aiden-lee11/clickshot/demo/README.md

# Clickshot — split walkthrough demo

Run `npm start` from `~/Developer/clickshot/demo`, then open http://127.0.0.1:4173. Run `npm install` if dependencies are missing. `npm run check` checks JavaScript syntax.

## Presentation

The laptop camera and the physical scene share targets A, B and C. Click a target in either view or select **Play example**. The six-step sequence shows:

1. A camera click selects a stationary target.
2. The laptop converts pixel offsets to yaw and pitch (pinhole-camera angle calculation, with illustrative intrinsics).
3. An animated USB packet hands the command to the microcontroller.
4. The microcontroller moves the yaw and pitch servos. The orange aim marker converges on the selected target.
5. Only after centering, the simulated rangefinder samples the target distance.
6. The microcontroller applies an illustrative pitch trim and waits for confirmation.

Use the step buttons to revisit a stage, Pause/Resume to explain it, and Replay to restart from the home pose. Confirm foam shot or Simulate clap animates a foam dart; each shot needs another confirmation. Manual controls are folded away. Drag the 3D scene to orbit; Isometric restores the presentation view.

All camera, serial, sensor, microphone and firing events are simulated. Range trim is `(range − 1) × 1.2°`, an illustrative animation convention, not a calibrated ballistic solution. The displayed physical distances are illustrative; the 3D stage compresses distance for legibility. The visible dart animation is a presentation effect.

## Buildable mount concept

The model distinguishes matte printed parts, bought metal hardware, and a plywood base:

- **Print:** two gusseted cheek plates, an open frame cradle with balance adjustment slots, servo pockets/adapters, and bearing retainers. Candidate material: PETG. Velcro-style straps and pads secure the shell without blocking the top jam door or magazine removal.
- **Buy:** two 608 bearings; M8 bolts with smooth sleeves/spacers, washers and locknuts for the two short side pivots; M3 fasteners; a lazy-Susan turntable bearing; two standard positional metal-gear hobby servos with matching horns; plywood and soft feet.
- The two short pivot bolts attach to opposite sides of the printed cradle. No shaft passes through the blaster. Bearings support the pitch pivots, and a horn screws into a printed adapter to transfer servo torque.
- The bought turntable is bolted between the base and printed yaw deck. Its bearing supports the vertical load. A coaxial servo/horn adapter turns the deck. Hardware fit, assembly access and cable slack must be resolved in CAD around the actual purchased parts.
- Align the loaded center of mass with the pitch pivots using the slotted cradle. The model is not dimensioned CAD or a structural validation. Measure blaster mass, loaded balance, clearances and required torque before buying servos. Bearing fit and printed-part strength need prototype checks. No custom metal machining is assumed; ordinary drilling and screw assembly are.

### Manufacturer and assembly references

- [Adafruit: 608 bearings installed in printed servo holders](https://learn.adafruit.com/animatronic-cosplay-wings/servos-assembly)
- [Pololu: standard-size servo bracket and M3 mounting](https://www.pololu.com/product/3435)
- [LILY Bearing: lazy-Susan bearing examples](https://www.lily-bearing.com/product/applications/lazy-susan-bearings/)
- [Adafruit: standard metal-gear servo example](https://www.adafruit.com/product/1142)

These are component examples, not a validated purchase list or a claim that a particular servo will carry this blaster. The linked shopping lists distinguish listed prices from planning allowances; the mock does not validate load ratings.

## Source

`index.html` contains the split presentation interface; `style.css` the responsive layout; `app.js` the procedural Three.js model, target coordinates and walkthrough state machine; `server.mjs` serves on loopback locally, and on `0.0.0.0` in production using Railway’s `PORT`. Only presentation assets, build notes and Three.js modules are public. Three.js is pinned in the package lock and served locally. The app makes no remote runtime requests. Reference links only open when clicked.

## Rapidstrike and second-stage presentation revision

The procedural blaster now follows the full Rapidstrike CS-18 silhouette and a published approximate 685 mm length reference. The new `mount-plan.md` records the source, proposed 360 × 300 mm base, 140 mm inner gap and 250 mm pivot height, and a linked candidate BOM. Local shell geometry and fit remain provisional until measured. Open **Original mount → View mount shopping list** for the supplier table and a plan download.

The embedded stage has larger live readings and a dedicated before/trim/after pitch comparison. The correction ramps over 3.2 seconds, with a blue camera-centered ghost pose and reference ray. The actual gun angle and orange ray move by the displayed trim; the physical rotation is not artificially magnified. **Replay trim** restarts just that motion. The laptop's command values are smaller and fade after handoff. Styling for this revision is isolated in `stage-two.css`.

## Plywood mount alternative

The **Plywood alternative** tab adds a separate assembly while preserving the original printed mount. It uses a plywood deck/uprights/open cradle, ordinary angle brackets, a bought yaw bearing, supported pitch pivots and small printed adapters. Yaw/pitch sliders, an automatic sweep and the shared exploded-view control demonstrate both axes. The pitch crank/pushrod stays connected in the assembled animation. See `plywood-mount-plan.md` for provisional dimensions, parts, Ford-resource assumptions and assembly notes. This is a concept mock, not validated CAD or a load-tested mechanism.

## Shared budget assumptions

The team has a micro:bit, cables, resistors, access to a 3D printer and existing filament spools. Printing is $0 new spend for both mount options. Both lists keep straps budgeted and show the same two cases: purchase other mount materials, or conditionally obtain wood/common hardware from Ford at no charge. Ford stock remains unconfirmed. Original mount: $98.36 / $71.42; plywood alternative: $115.93 / $81.42. Both include two aiming servos and exclude the rest of the electrical system, tax and shipping.

## Railway hosting

Live demo: https://clickshot-demo-production.up.railway.app

The initial deployment uses the Railway CLI. GitHub automatic deployment is **not connected yet** because the existing Railway GitHub integration could not access this repository.

Deploy the GitHub repository `aiden-lee11/clickshot`, branch `main`, with service **Root Directory** `/demo` and **Railway Config File** `/demo/railway.json`. Railpack installs the locked dependencies and runs `npm start`. Set `NODE_ENV=production`; Railway supplies `PORT`. Health checks request `/`. No database or application secrets are needed.

When the service is connected to GitHub with automatic deployments enabled, pushing changes to `main` updates the shared demo. Run `npm run check` before pushing. For a manual deployment from the linked repository root, run `railway up demo --path-as-root --service clickshot-demo`. This uploads only the demo folder as the deployment root; keep Root Directory unset for this CLI workflow. Run `railway link` first on another computer and select the Clickshot project.

To enable automatic deployments later, grant the Railway GitHub app access to this repository, connect the service to `aiden-lee11/clickshot` on `main`, and set the GitHub service Root Directory to `/demo` with config path `/demo/railway.json`. Do not use the folder-as-root CLI upload after setting that GitHub root directory.

Reference: [Railway monorepo settings](https://docs.railway.com/deployments/monorepo) and [GitHub automatic deployments](https://docs.railway.com/deployments/github-autodeploys).

## Prototype CAD

Open `/cad/` for the CAD-mesh viewer, exported STEP assembly, print-oriented STLs and source ZIP. The generator and editable dimensions live in `cad/generate.py` and `cad/parameters.json`. Read `cad/README.md` before fabrication. The CAD is a fit draft of the printed mount, with an external pitch linkage and optional replacement sleeves, while both presentation concepts remain preserved. Its provisional hardware schedule differs from the original concept shopping list; existing shopping totals are not quotes for the CAD revision.

## Compact inverted concept

The **Compact inverted** tab adds a third material-first mount mock. The receiver is shortened and inverted, with the magazine above, two short cutout cheeks, light saddles/rails, a web deck and side-driven yaw. The existing printed/plywood scenes and earlier CAD pack are preserved. `compact-mount.js` owns the new procedural assembly and crank/rod closures; `compact.css` its presentation. See `compact-mount-plan.md` for the proposed 100 mm pitch height, 260 × 220 mm base, material-proxy methodology and unresolved balance/inverted-feeding checks. The on-screen plastic-volume reduction compares rendered print-material geometry against the original scene, not slicer filament or CAD strength. This concept has no new fabrication CAD.

## Recommended hybrid and build navigation

The top navigation now has **Walkthrough** and **Mount builds**. A selector and previous/next arrows switch among the four assemblies: Original printed, Plywood frame, Compact inverted and Recommended hybrid. Direct links use `#original`, `#plywood`, `#compact` and `#recommended`.

The recommended mock shares the illustrative trimmed receiver with the compact model, but uses solid flat plywood uprights/deck, small printed bearing housings, bought pitch bearings, wood risers and coaxial yaw underneath. It has one pitch linkage. See `recommended-mount-plan.md`; this concept does not replace or update the earlier CAD pack or price lists.

## Recommended-build shopping list

Open **Mount builds → Recommended hybrid → View complete shopping list**. The dialog covers mount/movement, sensing/interfaces, power/blaster switching, and demo consumables. `recommended-shopping.js` is the single source for quantities, integer-cent prices, estimates and conditional Ford savings. `node scripts/build-shopping-list.mjs` regenerates the downloadable `recommended-shopping-list.md`; run it after changing the data. The app serves both locally without external runtime requests.

This is a complete candidate BOM, unlike the earlier mount-only lists. It assumes reuse of the donor Rapidstrike/magazine/tray and webcam named in the project notes; conditional replacement allowances are excluded. Micro:bit, class signal/USB cables, resistors, printer and filament are covered. Motor power wire and specialized connections are budgeted separately. Supply/driver ratings, pivot hardware, linkage and servo torque require physical selection checks; the recommended mock is not fabrication CAD.

## Class-resource budget revision

The recommended shopping dialog now leads with a conditional **$62.75 parts plan**, leaving **$57.25** toward tax/shipping/missing supplies within $120. Without class breakout/two pots and usable existing C cells, the parts subtotal is **$80.17** before tax/shipping. Both cases depend on confirmed Ford wood/hardware/clamps, adequate borrowed servo power and class wiring/capacitors/board, plus reuse of small consumables. They are not confirmed-free-stock or guaranteed checkout totals. The retail fallback now totals $232.34 with the two aiming servos marked owned, replacing the earlier $272.24 reference that included buying them.

`recommended-budget.js` derives the source groups and new purchase subtotals from the original retail data, substituting a $3.99 two-pack of 8×22×7 mm bearings for the $15.54 pair. Regenerate both Markdown files with `node scripts/build-shopping-list.mjs`. See `recommended-budget-plan.md` for sources, exact reconciliation, missing-resource add-backs and retained MVP functions.

Both aiming servos are confirmed owned. Their exact models are unspecified, so their power requirements, mounting pattern and horn spline must be measured before choosing adapters or treating the example 5 V supply as suitable. Ownership reduces the new-purchase budget by the prior $39.90 allowance; it does not identify the servos as the linked Adafruit model.

## Wiring visualization

Enable **Show wiring** under the build selector in **Mount builds**. The same toggle applies to all four assemblies and stays selected while switching builds. It starts off; the walkthrough remains unchanged. Wiring mode replaces dimension callouts with a compact color key and labels the base controller, motor switches, servo power and two separate laptop USB connections.

`build-wiring.js` anchors cable bundles to the fixed base, yaw frame, pitch cradle and blaster in each model. They follow yaw/pitch sweeps and the exploded view, with illustrative service loops at both joints. Servo power/common ground, servo/motor control, range/position feedback, camera/controller USB and both switched blaster motor branches are distinct. The camera USB route returns directly to the laptop rather than through the micro:bit. Light markers illustrate signal direction, not live serial traffic. The overlays and extra base components hide when disabled or in Walkthrough.

The wiring is a routing concept, not an electrical schematic, physical clearance validation, exact wire count/length, selected gauge or final pin mapping. The exploded view stretches routes for presentation. Added base component envelopes and feedback endpoints are provisional. Verify actual owned-servo power requirements and complete the circuit design before assembly. Cable geometry buffers are reused and reshaped only while the pose changes; hidden builds do not update their wiring.

## Manual aiming and simulated shots

In **Walkthrough → Manual controls**, changing yaw or pitch enters manual aiming mode. The turret moves smoothly to those angles; **Confirm foam shot**, **Simulate clap** and the existing space shortcut become available once the aim settles. No laptop target click is required. A manual shot follows the current barrel direction to the selected demo range rather than snapping to a previous target. Manual pitch is used directly; the automatic range-trim walkthrough is bypassed in this mode. Each action fires one simulated dart and shares a 1.2-second cooldown.

Clicking a laptop/scene target returns to the automatic walkthrough. Reset and tab/build changes clear manual readiness. Mount builds remain assembly views. The fire handler and buttons share the same eligibility check, including alignment and cooldown, so keyboard input cannot bypass movement or firing cooldown.
