aiden-lee11/clickshot/demo/cad/generated/clickshot-assembly.step

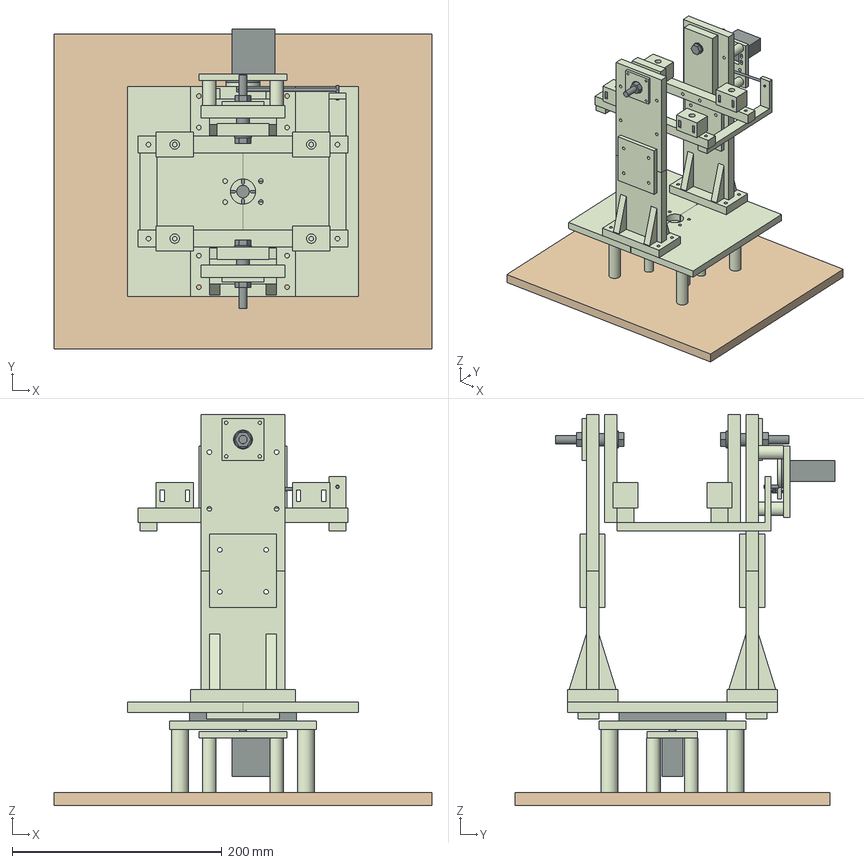
[picture p1: CAD file, 2026-10-26]
demo/cad/generated/clickshot-assembly.step
360.0 x 304.9 x 372.6 mm
yaw_deck_left
yaw_deck_right
deck_joiner_0
deck_joiner_1
bearing_platform
yaw_post_0
yaw_post_1
yaw_post_2
yaw_post_3
yaw_horn_adapter
servo_carrier_yaw
yaw_servo_post_0
yaw_servo_post_1
yaw_servo_post_2
yaw_servo_post_3
pitch_servo_carrier_pitch
pitch_servo_post_0
pitch_servo_post_1
pitch_servo_post_2
pitch_servo_post_3
lower_cheek_-1
upper_cheek_-1
cheek_splice_-1_-1
cheek_splice_-1_1
bearing_retainer_-1
cradle_rail_-1
cradle_pivot_ear_-1
saddle_block_-1_0
saddle_block_-1_1
608_bearing_-1
pivot_spacer_-1
M8_pivot_reference_-1
M8_washer_inner_-1
M8_washer_outer_-1
M8_head_-1
M8_nut_-1
lower_cheek_1
upper_cheek_1
cheek_splice_1_-1
cheek_splice_1_1
bearing_retainer_1
cradle_rail_1
cradle_pivot_ear_1
saddle_block_1_0
saddle_block_1_1
608_bearing_1
pivot_spacer_1
M8_pivot_reference_1
M8_washer_inner_1
M8_washer_outer_1
M8_head_1
M8_nut_1
rear_crossmember
front_drive_crossmember
pitch_crank_adapter
pushrod_reference
servo_joint_pin
cradle_joint_pin
yaw_servo_envelope
yaw_bought_horn_reference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
