aiden-lee11/clickshot/demo/cad/generated/preview/servo_joint_pin.stl

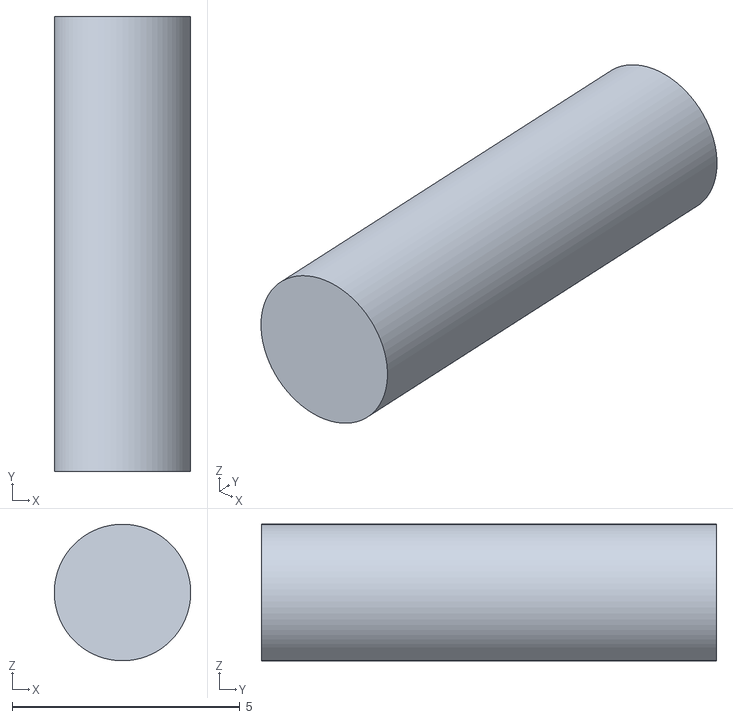
[picture p2: CAD file, 2026-10-26]
demo/cad/generated/preview/servo_joint_pin.stl
3.00 x 10.0 x 3.00
