aiden-lee11/clickshot/demo/cad/generated/step/yaw_post.step

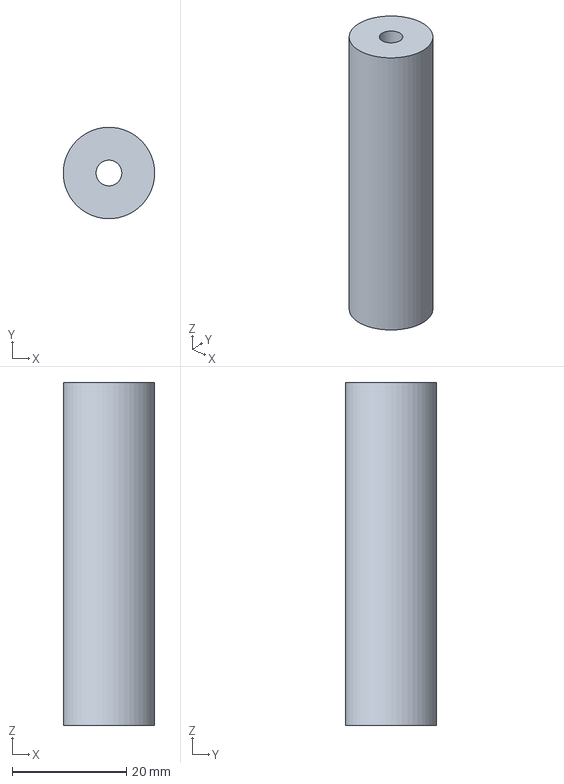
[picture p3: CAD file, 2026-10-26]
demo/cad/generated/step/yaw_post.step
16.0 x 16.0 x 60.0 mm
