aiden-lee11/clickshot/demo/cad/generated/preview/pitch_servo_post_2.stl

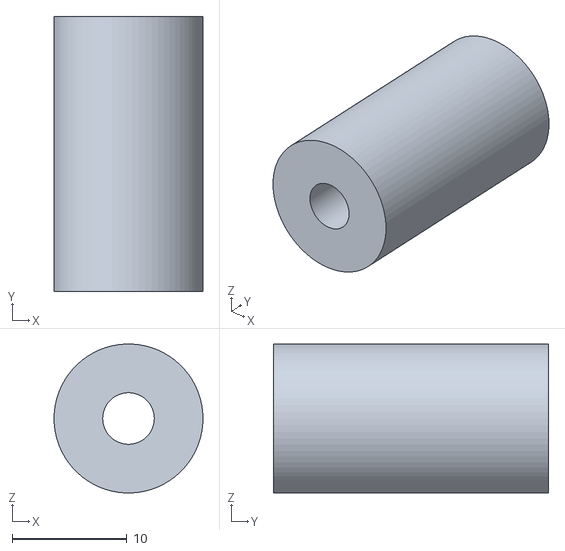
[picture p4: CAD file, 2026-10-26]
demo/cad/generated/preview/pitch_servo_post_2.stl
13.0 x 24.0 x 13.0
