aiden-lee11/clickshot/demo/cad/generated/preview/lower_cheek_-1.stl

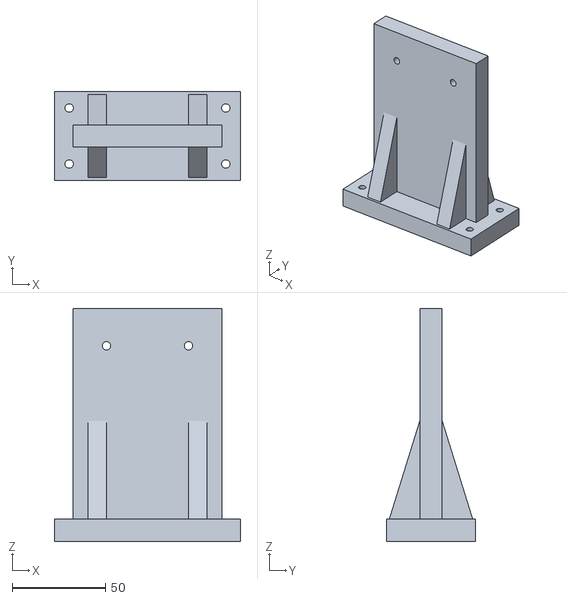
[picture p5: CAD file, 2026-10-26]
demo/cad/generated/preview/lower_cheek_-1.stl
100.0 x 48.0 x 125.0
