aiden-lee11/clickshot/demo/cad/generated/step/yaw_deck_left.step

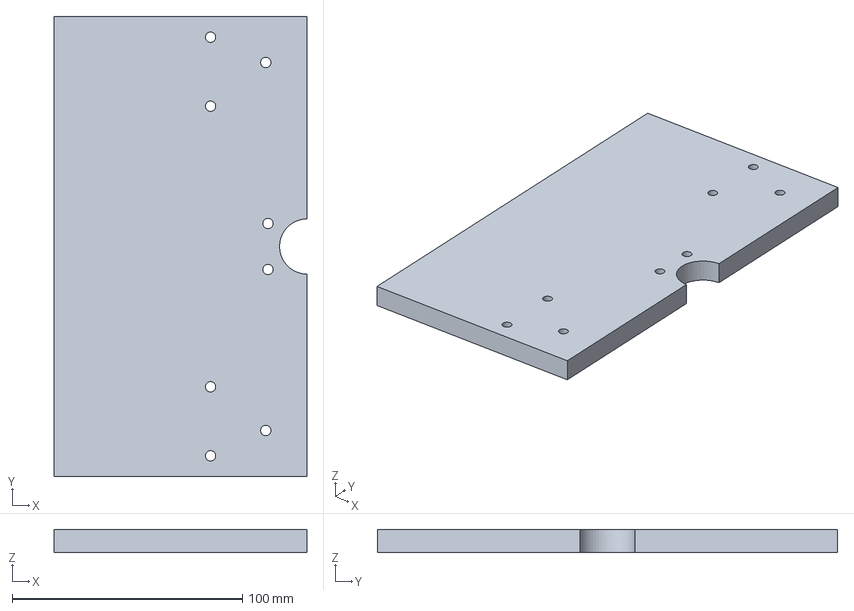
[picture p6: CAD file, 2026-10-26]
demo/cad/generated/step/yaw_deck_left.step
109.8 x 200.0 x 10.0 mm
