aiden-lee11/clickshot/demo/cad/generated/preview/pitch_crank_adapter.stl

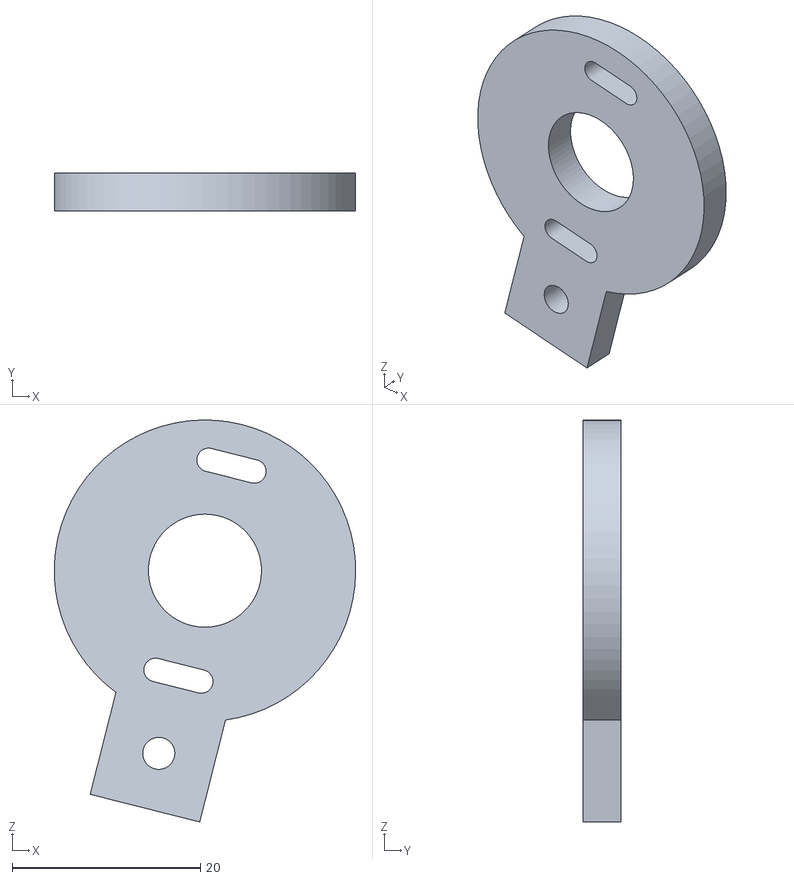
[picture p7: CAD file, 2026-10-26]
demo/cad/generated/preview/pitch_crank_adapter.stl
32.0 x 4.00 x 42.7
