aiden-lee11/clickshot/demo/cad/generated/step/cradle_pivot_ear.step

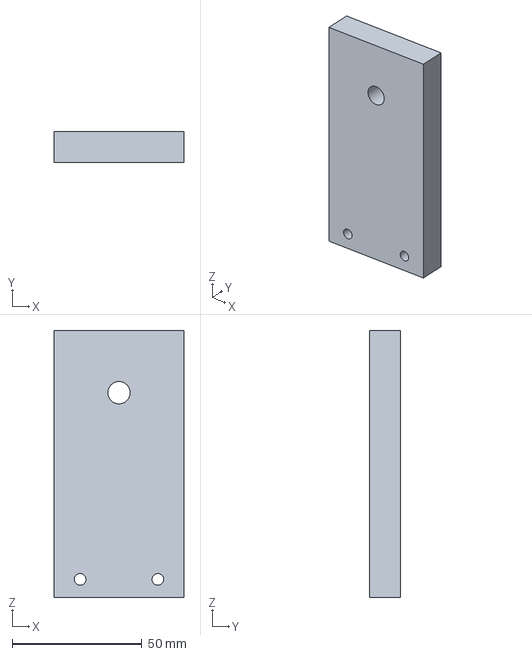
[picture p8: CAD file, 2026-10-26]
demo/cad/generated/step/cradle_pivot_ear.step
50.0 x 12.0 x 103.0 mm
