aiden-lee11/clickshot/demo/cad/generated/preview/saddle_block_-1_1.stl

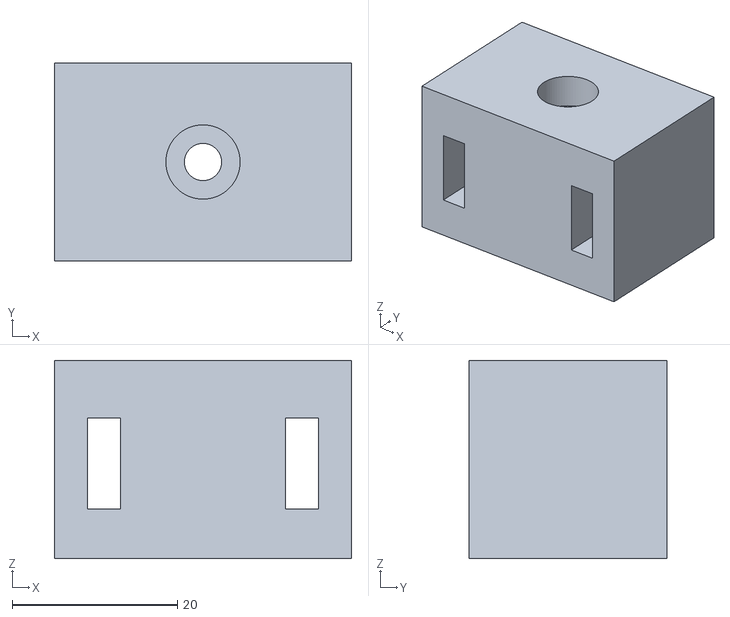
[picture p9: CAD file, 2026-10-26]
demo/cad/generated/preview/saddle_block_-1_1.stl
36.0 x 24.0 x 24.0
