aiden-lee11/clickshot/demo/cad/generated/step/fit_coupon.step

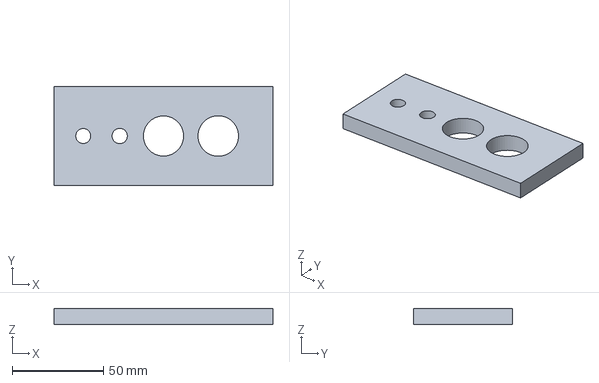
[picture p10: CAD file, 2026-10-26]
demo/cad/generated/step/fit_coupon.step
120.0 x 54.0 x 9.00 mm
