aiden-lee11/clickshot/demo/cad/generated/preview/pitch_bought_horn_reference.stl

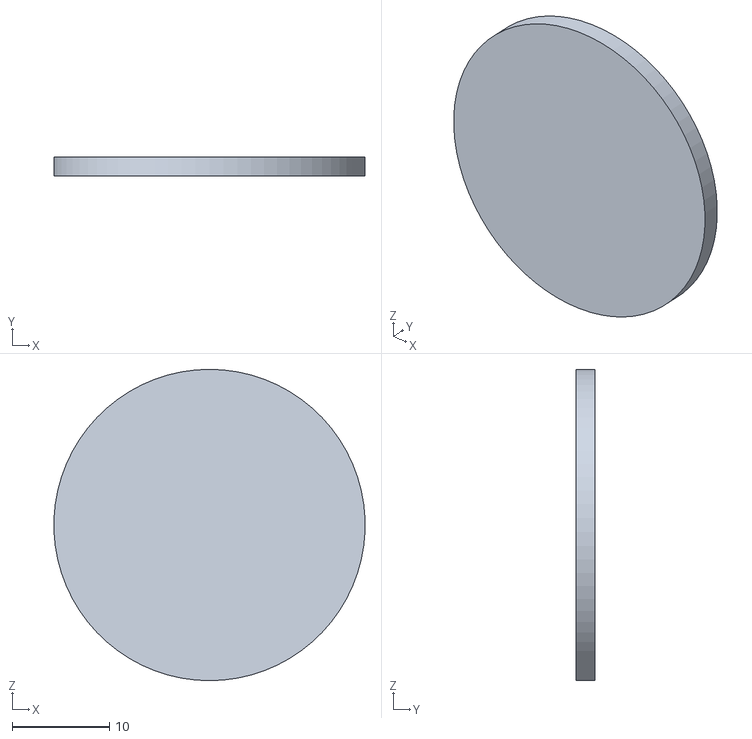
[picture p11: CAD file, 2026-10-26]
demo/cad/generated/preview/pitch_bought_horn_reference.stl
32.0 x 2.00 x 32.0
