aiden-lee11/clickshot/demo/cad/generated/step/deck_joiner.step

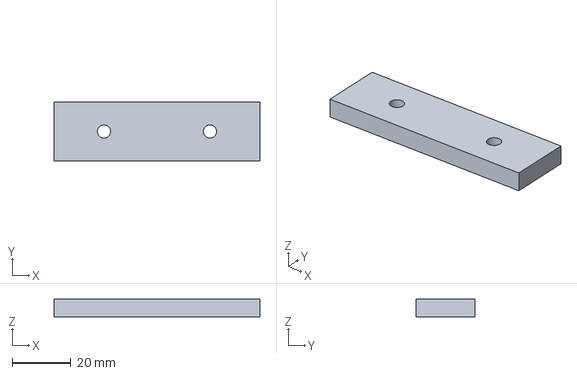
[picture p12: CAD file, 2026-10-26]
demo/cad/generated/step/deck_joiner.step
70.0 x 20.0 x 6.00 mm
