aiden-lee11/clickshot/demo/cad/generated/step/bearing_platform.step

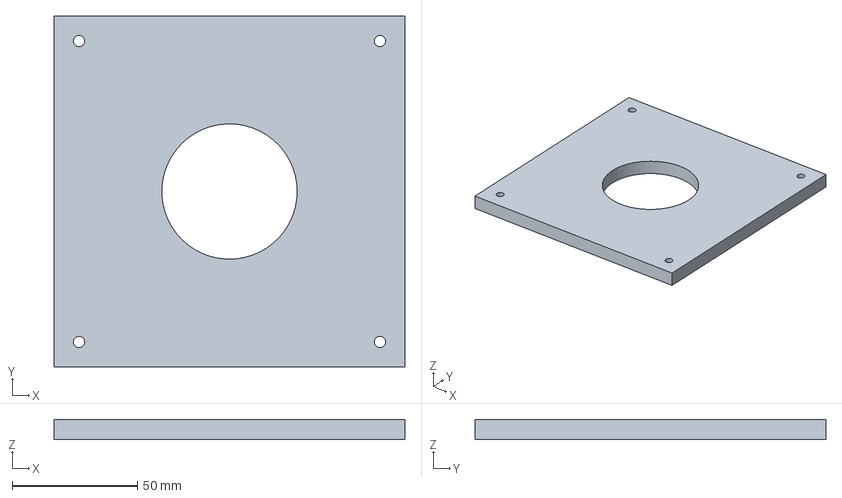
[picture p13: CAD file, 2026-10-26]
demo/cad/generated/step/bearing_platform.step
140.0 x 140.0 x 8.00 mm
