aiden-lee11/clickshot/demo/cad/generated/preview/pivot_spacer_-1.stl

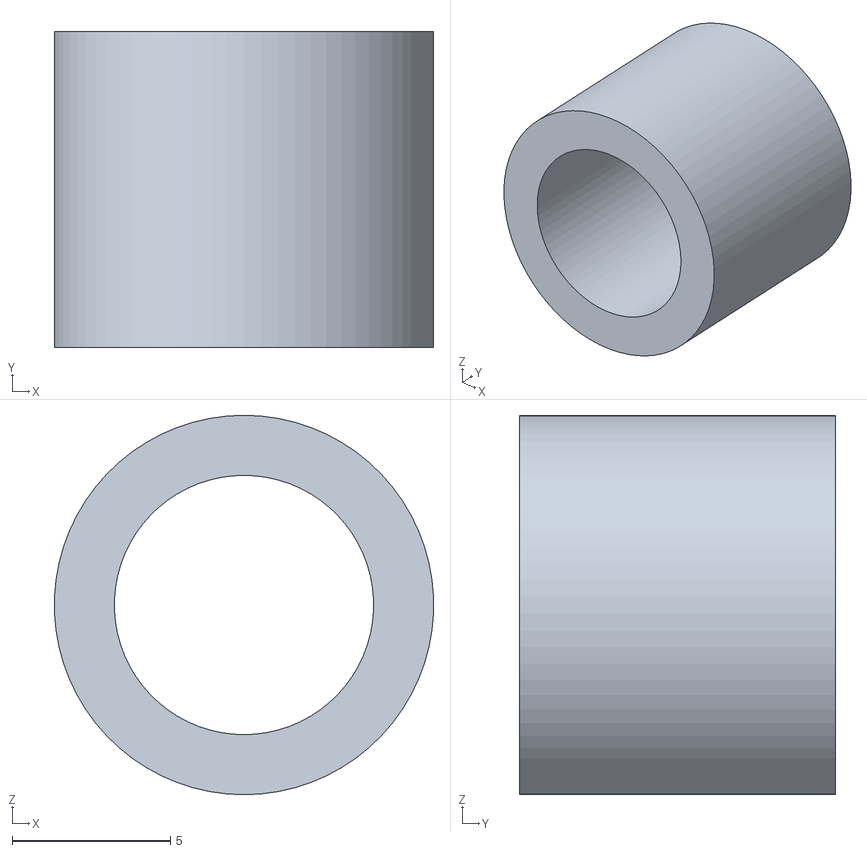
[picture p14: CAD file, 2026-10-26]
demo/cad/generated/preview/pivot_spacer_-1.stl
12.0 x 10.0 x 12.0
