aiden-lee11/clickshot/demo/cad/generated/step/servo_carrier.step

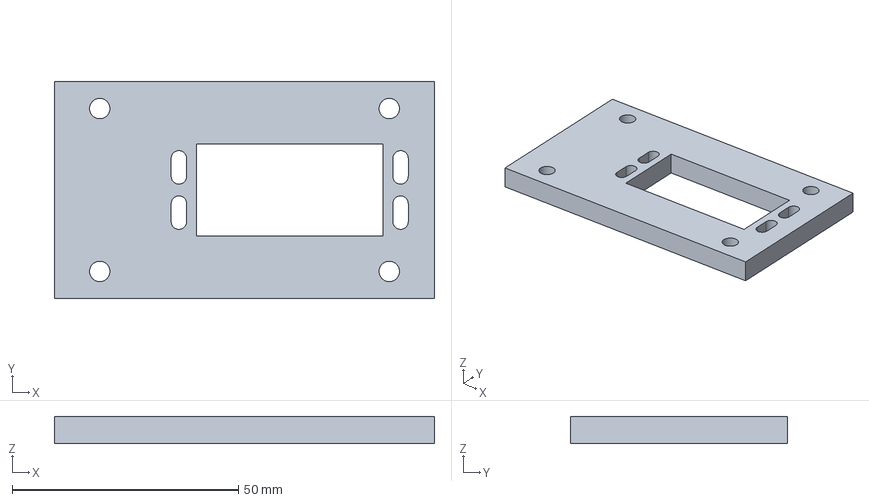
[picture p15: CAD file, 2026-10-26]
demo/cad/generated/step/servo_carrier.step
84.0 x 48.0 x 6.00 mm
