aiden-lee11/clickshot/demo/cad/generated/step/cradle_rail.step

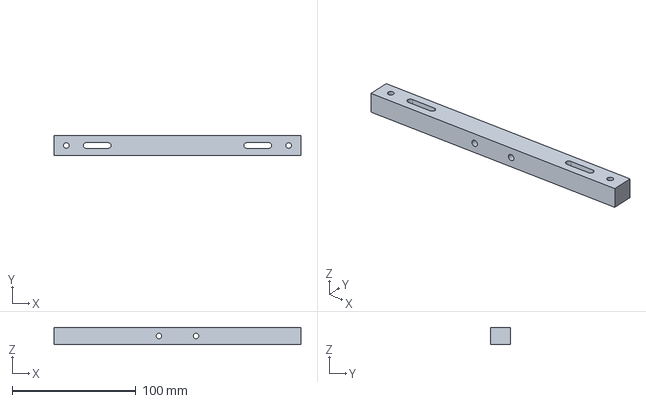
[picture p16: CAD file, 2026-10-26]
demo/cad/generated/step/cradle_rail.step
200.0 x 16.0 x 14.0 mm
