aiden-lee11/clickshot/demo/cad/generated/step/bearing_retainer.step

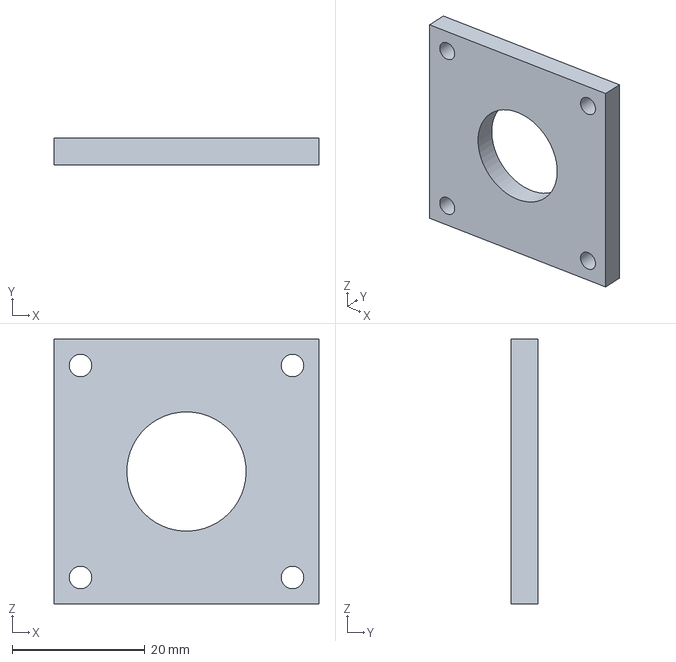
[picture p17: CAD file, 2026-10-26]
demo/cad/generated/step/bearing_retainer.step
40.0 x 4.00 x 40.0 mm
