aiden-lee11/clickshot/demo/cad/generated/preview/608_bearing_-1.stl

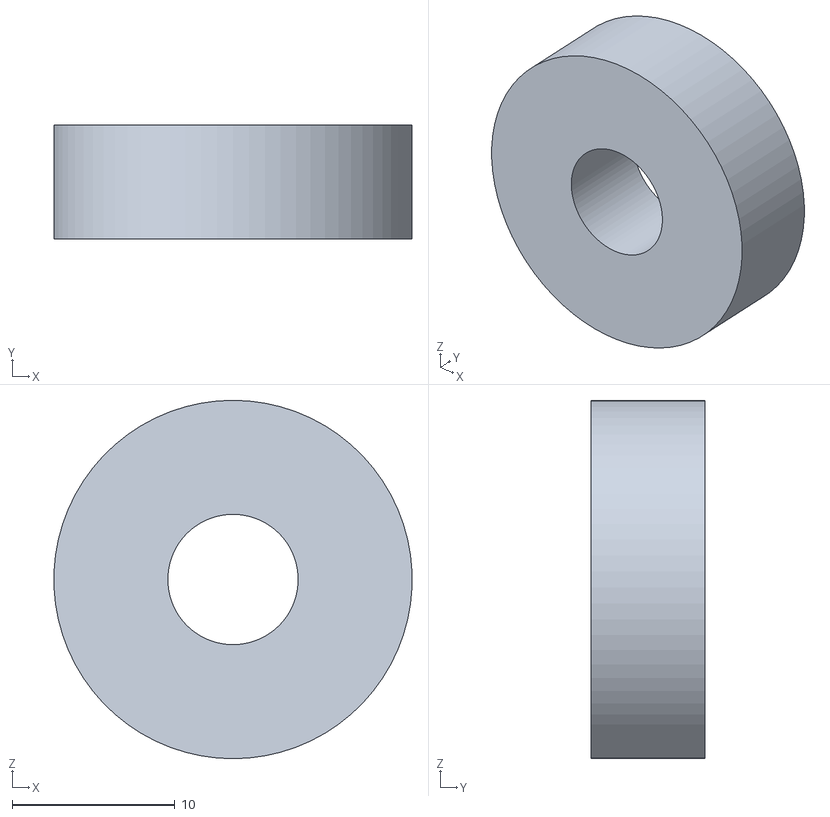
[picture p18: CAD file, 2026-10-26]
demo/cad/generated/preview/608_bearing_-1.stl
22.0 x 7.00 x 22.0
