aiden-lee11/clickshot/demo/cad/generated/preview/M8_head_-1.stl

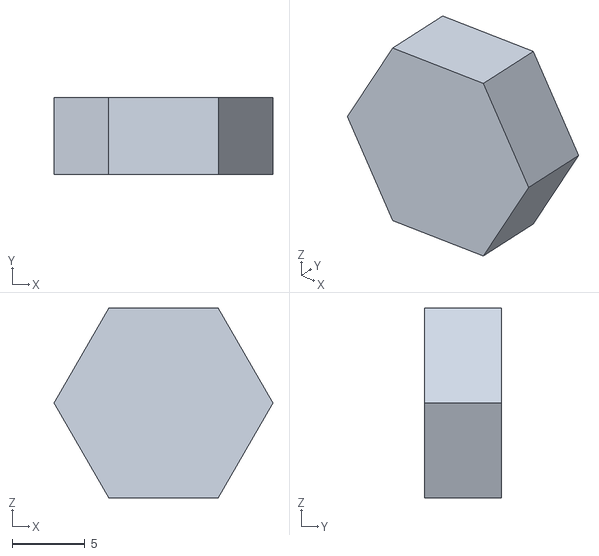
[picture p19: CAD file, 2026-10-26]
demo/cad/generated/preview/M8_head_-1.stl
15.0 x 5.30 x 13.0
