aiden-lee11/clickshot/demo/cad/generated/step/pitch_servo_carrier.step

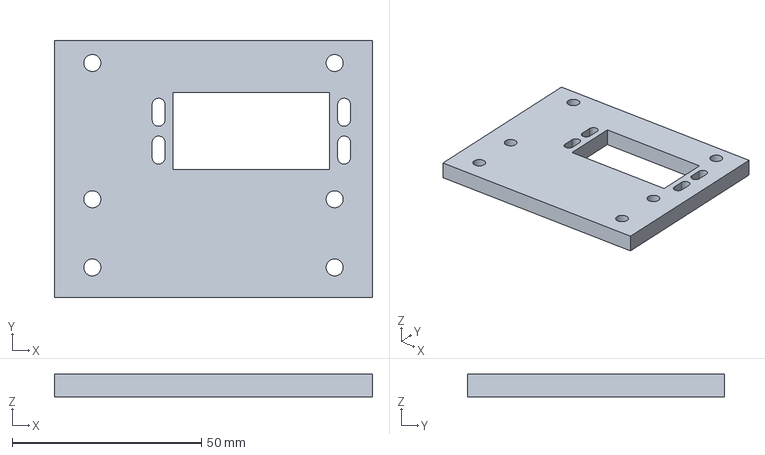
[picture p20: CAD file, 2026-10-26]
demo/cad/generated/step/pitch_servo_carrier.step
84.0 x 68.0 x 6.00 mm
