aiden-lee11/clickshot/demo/cad/generated/step/saddle_block.step

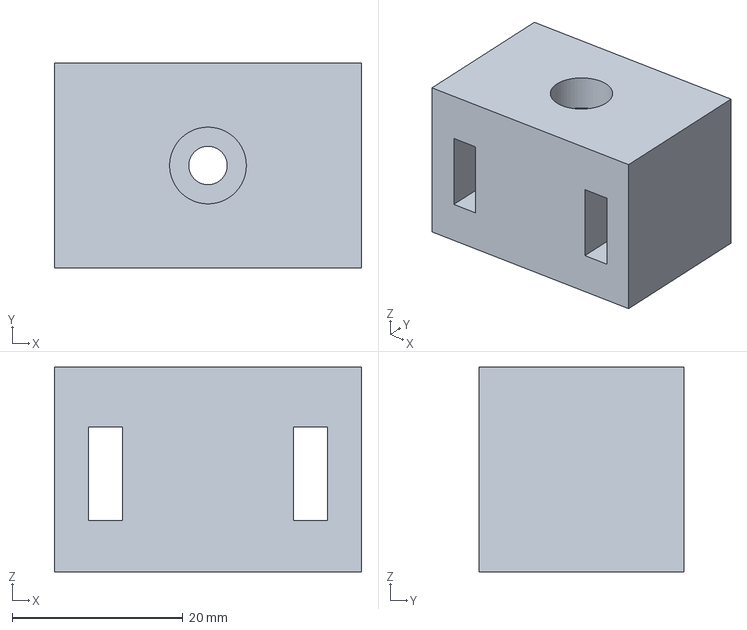
[picture p21: CAD file, 2026-10-26]
demo/cad/generated/step/saddle_block.step
36.0 x 24.0 x 24.0 mm
