aiden-lee11/clickshot/demo/cad/generated/step/rear_crossmember.step

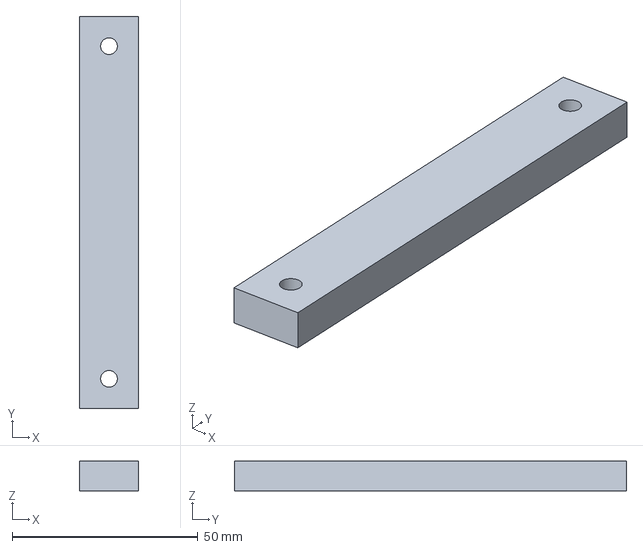
[picture p22: CAD file, 2026-10-26]
demo/cad/generated/step/rear_crossmember.step
16.0 x 105.6 x 8.00 mm
