aiden-lee11/clickshot/demo/cad/generated/preview/turntable_envelope.stl

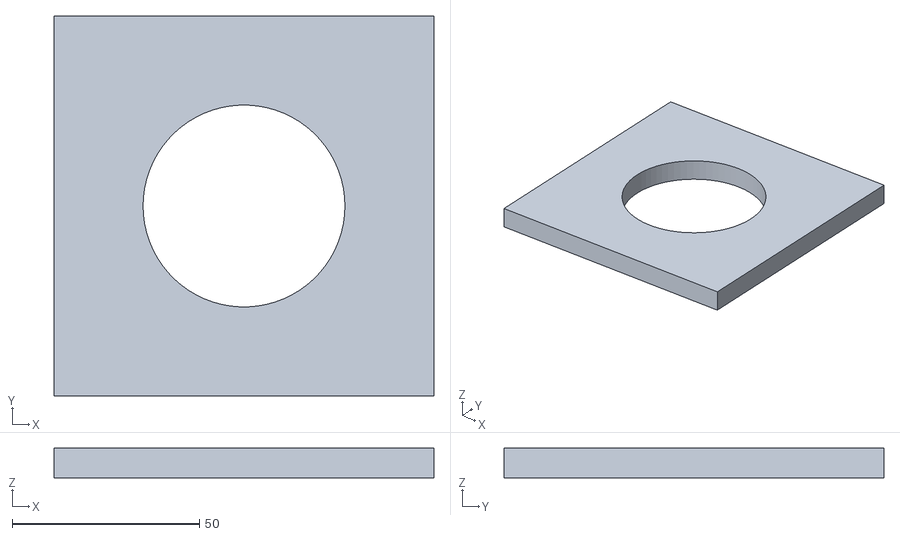
[picture p23: CAD file, 2026-10-26]
demo/cad/generated/preview/turntable_envelope.stl
101.6 x 101.6 x 7.94
