aiden-lee11/clickshot/demo/cad/generated/preview/yaw_servo_post_1.stl

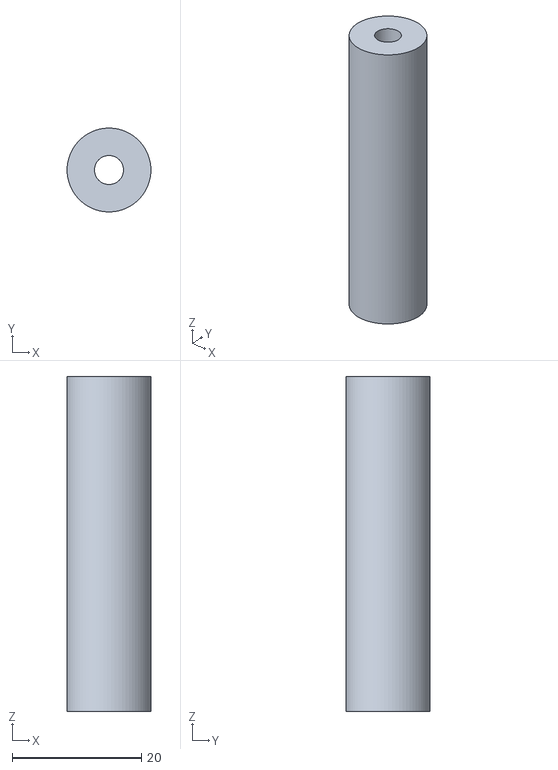
[picture p24: CAD file, 2026-10-26]
demo/cad/generated/preview/yaw_servo_post_1.stl
13.0 x 13.0 x 51.9
