aiden-lee11/clickshot/demo/cad/generated/step/front_drive_crossmember.step

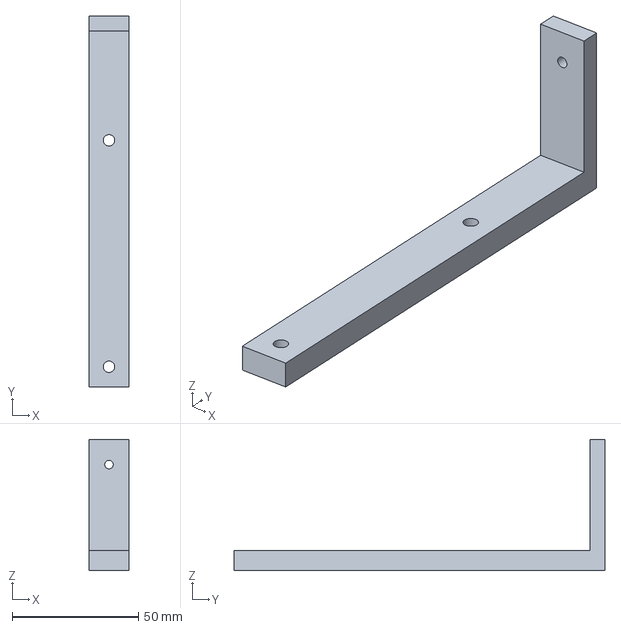
[picture p25: CAD file, 2026-10-26]
demo/cad/generated/step/front_drive_crossmember.step
16.0 x 146.8 x 52.0 mm
