aiden-lee11/clickshot/demo/cad/generated/preview/yaw_servo_shaft_reference.stl

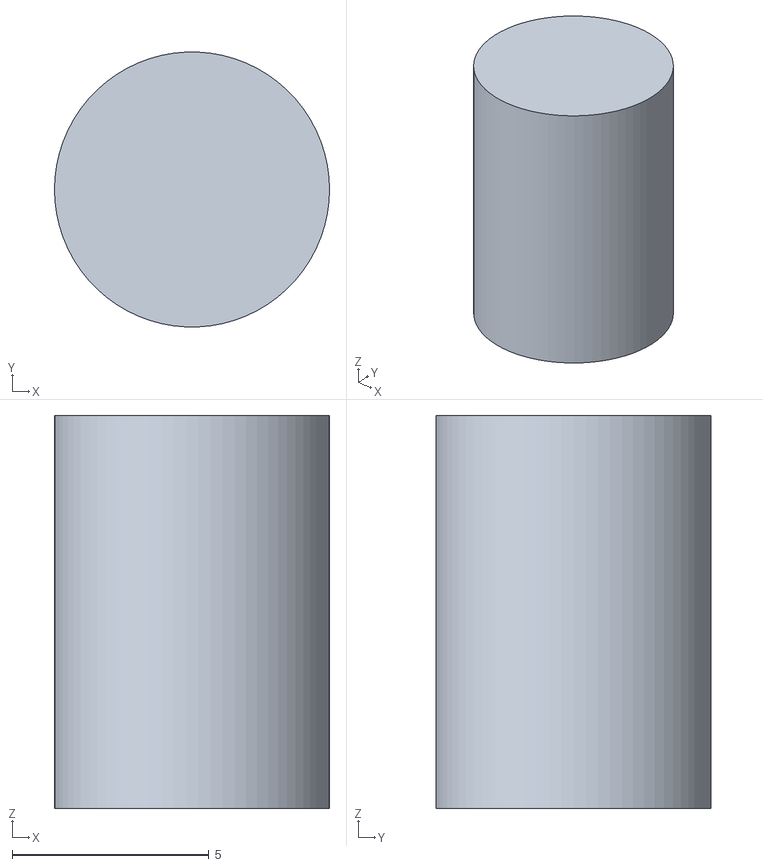
[picture p26: CAD file, 2026-10-26]
demo/cad/generated/preview/yaw_servo_shaft_reference.stl
7.00 x 6.99 x 10.0
