aiden-lee11/clickshot/demo/cad/generated/step/upper_cheek.step

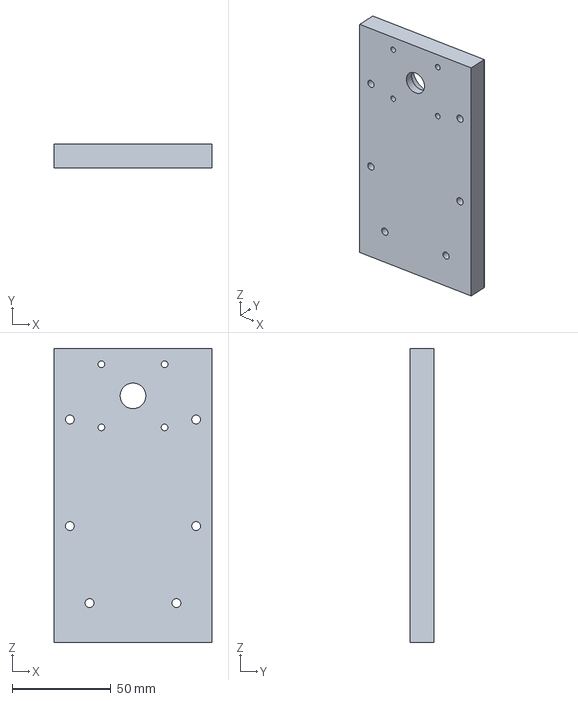
[picture p27: CAD file, 2026-10-26]
demo/cad/generated/step/upper_cheek.step
80.0 x 12.0 x 149.0 mm
