aiden-lee11/clickshot/demo/cad/generated/preview/pitch_servo_shaft_reference.stl

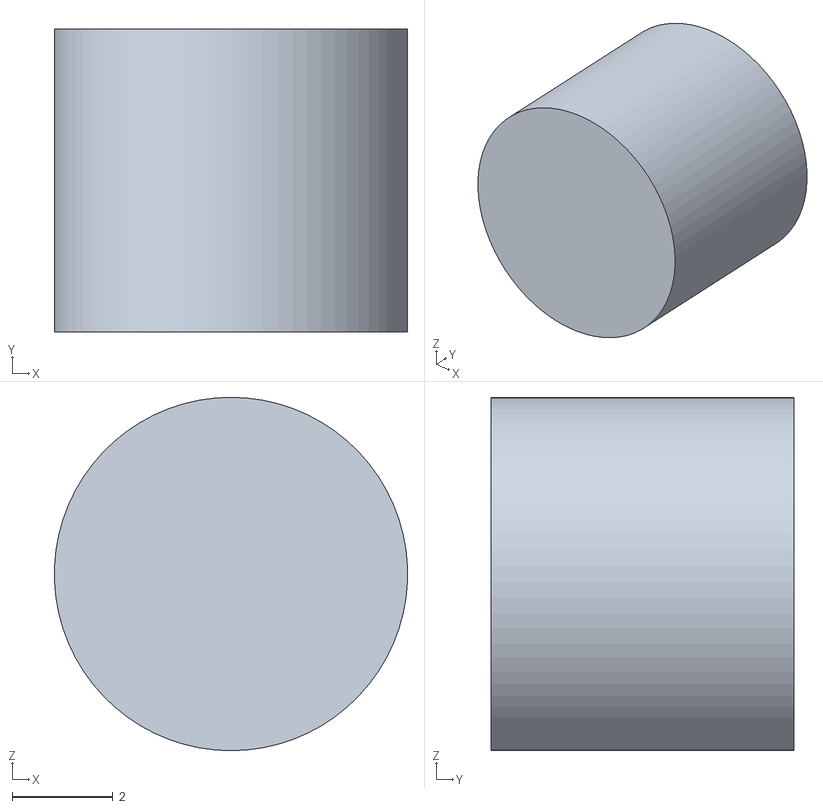
[picture p28: CAD file, 2026-10-26]
demo/cad/generated/preview/pitch_servo_shaft_reference.stl
6.99 x 6.00 x 7.00
