aiden-lee11/clickshot/demo/cad/generated/preview/cradle_joint_pin.stl

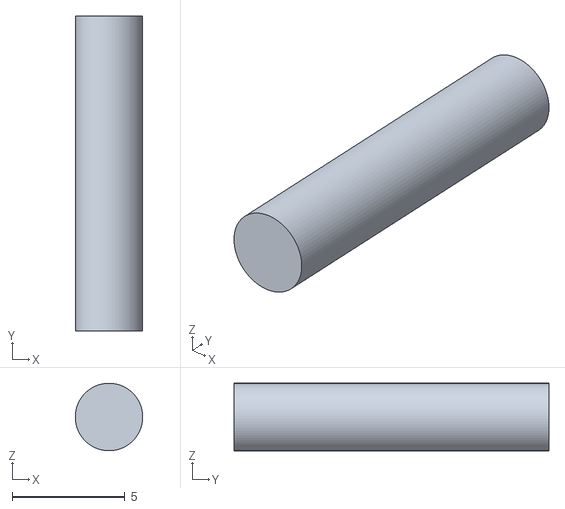
[picture p29: CAD file, 2026-10-26]
demo/cad/generated/preview/cradle_joint_pin.stl
3.00 x 14.0 x 3.00
