aiden-lee11/clickshot/demo/cad/generated/step/yaw_horn_adapter.step

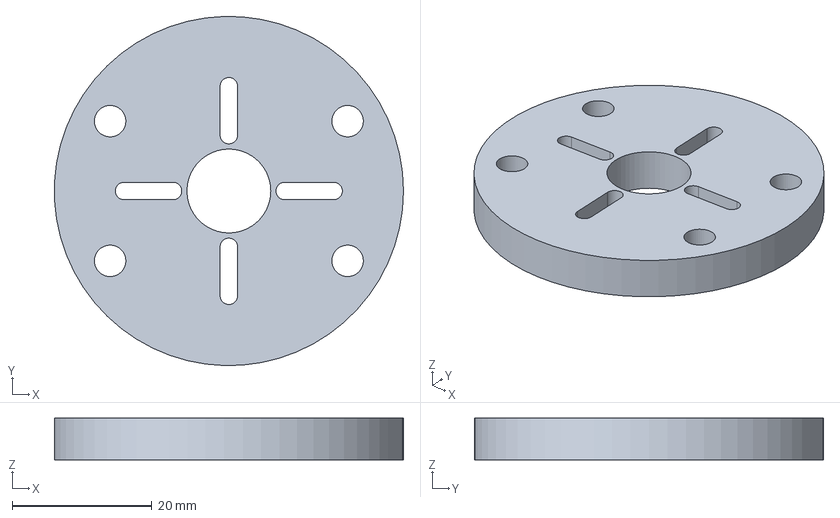
[picture p30: CAD file, 2026-10-26]
demo/cad/generated/step/yaw_horn_adapter.step
50.0 x 50.0 x 6.00 mm
