aiden-lee11/clickshot/demo/cad/generated/preview/M8_pivot_reference_-1.stl

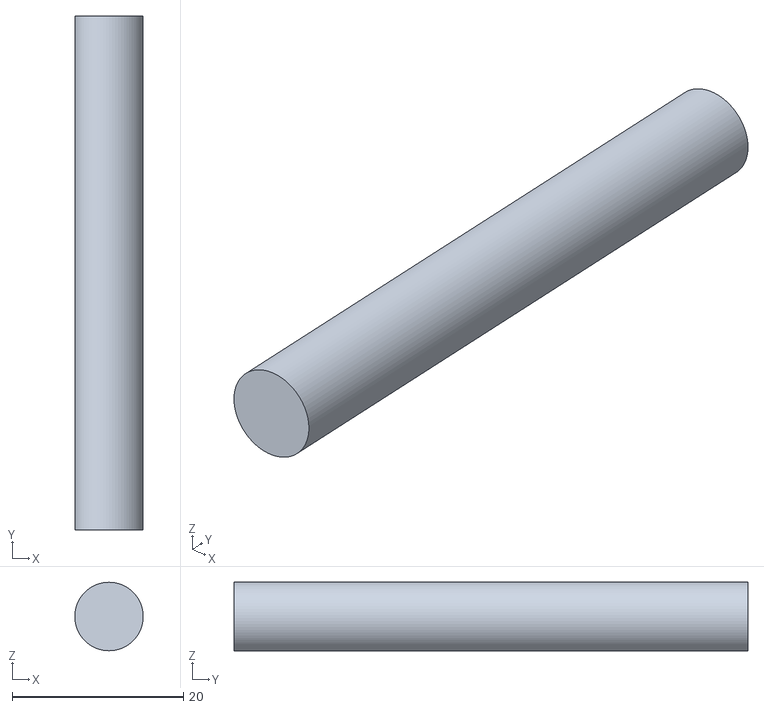
[picture p31: CAD file, 2026-10-26]
demo/cad/generated/preview/M8_pivot_reference_-1.stl
7.99 x 60.0 x 8.00
