aiden-lee11/clickshot/demo/cad/generated/step/cheek_splice.step

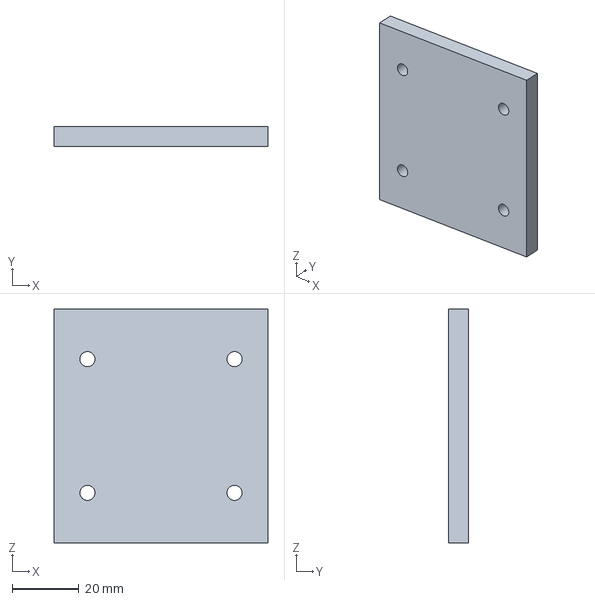
[picture p32: CAD file, 2026-10-26]
demo/cad/generated/step/cheek_splice.step
64.0 x 6.00 x 70.0 mm
