aiden-lee11/clickshot/demo/cad/generated/step/pitch_crank_adapter.step

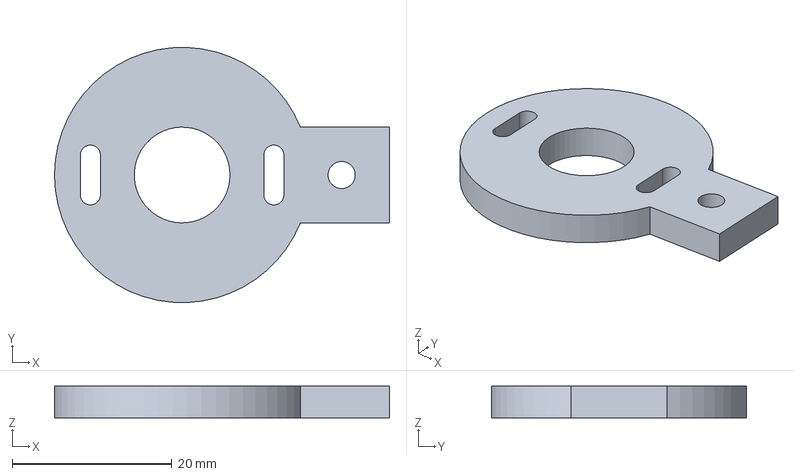
[picture p33: CAD file, 2026-10-26]
demo/cad/generated/step/pitch_crank_adapter.step
42.0 x 32.0 x 4.00 mm
