aiden-lee11/clickshot/demo/cad/generated/preview/pushrod_reference.stl

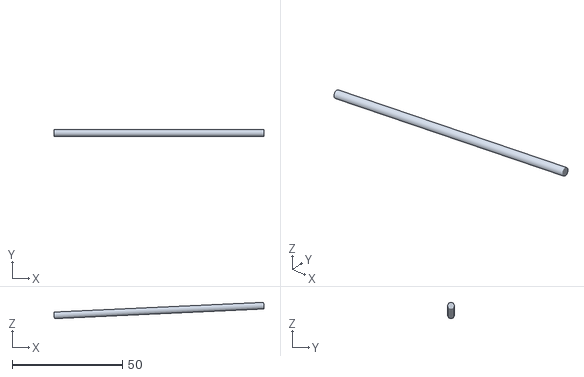
[picture p34: CAD file, 2026-10-26]
demo/cad/generated/preview/pushrod_reference.stl
95.0 x 3.00 x 7.39
