aiden-lee11/clickshot/demo/cad/generated/preview/plywood_base.stl

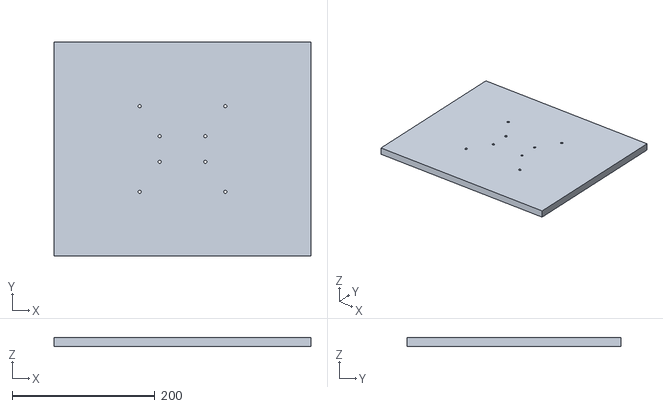
[picture p35: CAD file, 2026-10-26]
demo/cad/generated/preview/plywood_base.stl
360.0 x 300.0 x 12.7
