aiden-lee11/clickshot/demo/cad/generated/preview/yaw_servo_envelope.stl

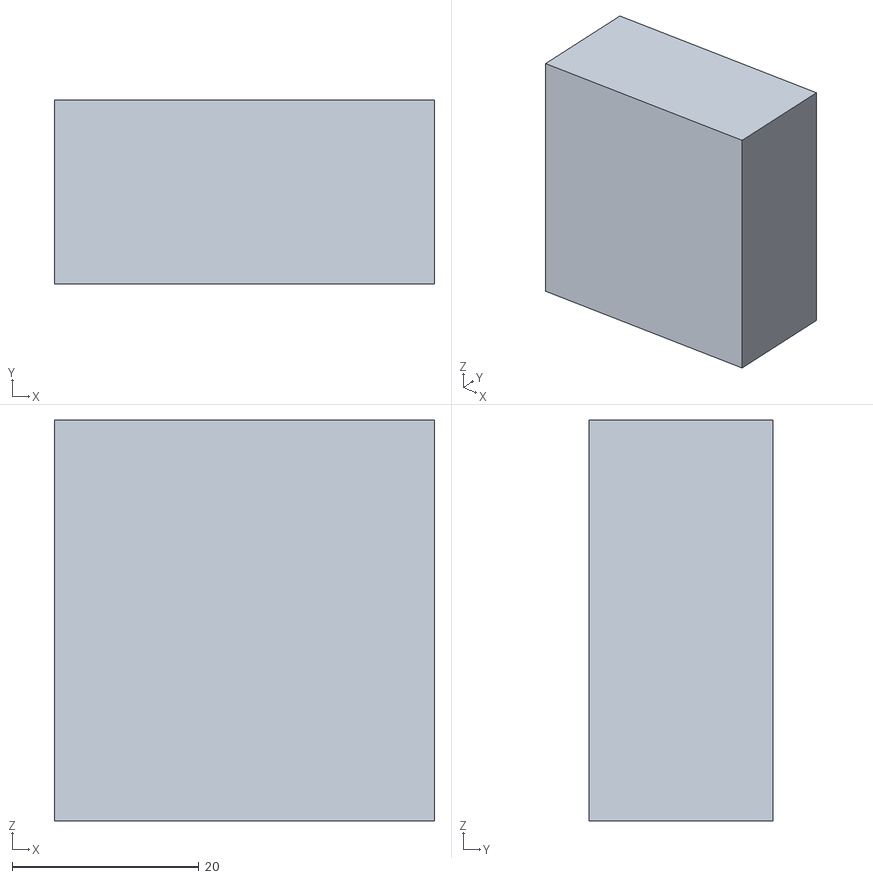
[picture p36: CAD file, 2026-10-26]
demo/cad/generated/preview/yaw_servo_envelope.stl
40.7 x 19.7 x 42.9
