aiden-lee11/clickshot/demo/cad/generated/preview/unmeasured_blaster_envelope.stl

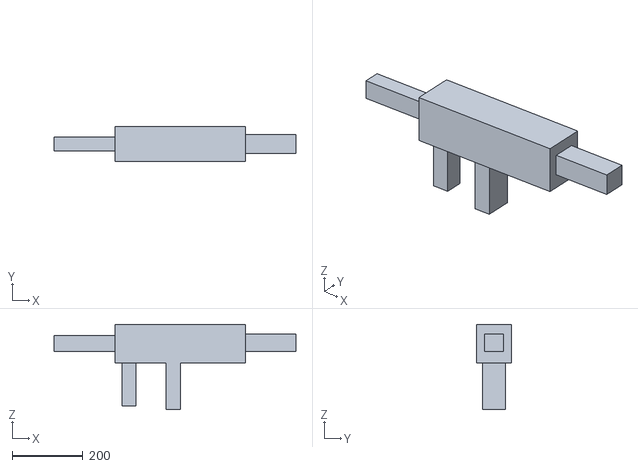
[picture p37: CAD file, 2026-10-26]
demo/cad/generated/preview/unmeasured_blaster_envelope.stl
685.0 x 100.0 x 242.0
