aiden-lee11/clickshot/(list of files, cad)

Other CAD files:
demo/cad/generated/step/pitch_servo_post.step
demo/cad/generated/preview/deck_joiner_0.stl
demo/cad/generated/preview/cradle_pivot_ear_-1.stl
demo/cad/generated/step/yaw_deck_right.step
demo/cad/generated/preview/saddle_block_-1_0.stl
demo/cad/generated/preview/cradle_rail_-1.stl
demo/cad/generated/step/optional_pitch_sleeve.step
demo/cad/generated/step/lower_cheek.step
demo/cad/generated/step/yaw_servo_post.step
demo/cad/generated/preview/yaw_post_1.stl
demo/cad/generated/preview/bearing_platform.stl
demo/cad/generated/preview/cheek_splice_-1_-1.stl
demo/cad/generated/preview/rear_crossmember.stl
demo/cad/generated/preview/front_drive_crossmember.stl
demo/cad/generated/preview/yaw_post_0.stl
demo/cad/generated/preview/yaw_post_2.stl
demo/cad/generated/preview/sleeve_alternative_-1.stl
demo/cad/generated/preview/yaw_bought_horn_reference.stl
demo/cad/generated/preview/yaw_post_3.stl
demo/cad/generated/preview/bearing_retainer_-1.stl
demo/cad/generated/preview/yaw_servo_post_2.stl
demo/cad/generated/preview/yaw_deck_left.stl
demo/cad/generated/preview/servo_carrier_yaw.stl
demo/cad/generated/preview/yaw_horn_adapter.stl
demo/cad/generated/preview/deck_joiner_1.stl
demo/cad/generated/preview/upper_cheek_-1.stl
demo/cad/generated/preview/pitch_servo_envelope.stl
demo/cad/generated/preview/yaw_deck_right.stl
demo/cad/generated/preview/pitch_servo_post_0.stl
demo/cad/generated/preview/yaw_servo_post_0.stl
demo/cad/generated/preview/pitch_servo_post_1.stl
demo/cad/generated/preview/pitch_servo_carrier_pitch.stl
demo/cad/generated/preview/yaw_servo_post_3.stl
demo/cad/generated/preview/pitch_servo_post_3.stl
demo/cad/generated/preview/608_bearing_1.stl
demo/cad/generated/preview/M8_head_1.stl
demo/cad/generated/preview/M8_nut_-1.stl
demo/cad/generated/preview/M8_nut_1.stl
demo/cad/generated/preview/M8_pivot_reference_1.stl
demo/cad/generated/preview/M8_washer_inner_-1.stl
demo/cad/generated/preview/M8_washer_inner_1.stl
demo/cad/generated/preview/M8_washer_outer_-1.stl
demo/cad/generated/preview/M8_washer_outer_1.stl
demo/cad/generated/preview/bearing_retainer_1.stl
demo/cad/generated/preview/cheek_splice_-1_1.stl
demo/cad/generated/preview/cheek_splice_1_-1.stl
demo/cad/generated/preview/cheek_splice_1_1.stl
demo/cad/generated/preview/cradle_pivot_ear_1.stl
demo/cad/generated/preview/cradle_rail_1.stl
demo/cad/generated/preview/lower_cheek_1.stl
demo/cad/generated/preview/pivot_spacer_1.stl
demo/cad/generated/preview/saddle_block_1_0.stl
demo/cad/generated/preview/saddle_block_1_1.stl
demo/cad/generated/preview/sleeve_alternative_1.stl
demo/cad/generated/preview/upper_cheek_1.stl
demo/cad/generated/stl/bearing_platform.stl
demo/cad/generated/stl/bearing_retainer.stl
demo/cad/generated/stl/cheek_splice.stl
demo/cad/generated/stl/cradle_pivot_ear.stl
demo/cad/generated/stl/cradle_rail.stl
demo/cad/generated/stl/deck_joiner.stl
demo/cad/generated/stl/fit_coupon.stl
demo/cad/generated/stl/front_drive_crossmember.stl
demo/cad/generated/stl/lower_cheek.stl
demo/cad/generated/stl/optional_pitch_sleeve.stl
demo/cad/generated/stl/pitch_crank_adapter.stl
demo/cad/generated/stl/pitch_servo_carrier.stl
demo/cad/generated/stl/pitch_servo_post.stl
demo/cad/generated/stl/rear_crossmember.stl
demo/cad/generated/stl/saddle_block.stl
demo/cad/generated/stl/servo_carrier.stl
demo/cad/generated/stl/upper_cheek.stl
demo/cad/generated/stl/yaw_deck_left.stl
demo/cad/generated/stl/yaw_deck_right.stl
demo/cad/generated/stl/yaw_horn_adapter.stl
demo/cad/generated/stl/yaw_post.stl
demo/cad/generated/stl/yaw_servo_post.stl
