aiden-lee11/clickshot/(commit log)

2026-10-26 Add plywood mount alternative with interactive pan and tilt
2026-10-26 Add priced shopping list for plywood mount
2026-10-26 Use existing printing supplies and align mount budget assumptions
2026-10-26 Prepare demo for Railway hosting
2026-10-26 Document live Railway demo and redeployment workflow
2026-10-26 Add parametric prototype mount CAD and assembly viewer
2026-10-27 Add compact inverted low-material mount concept
2026-10-27 Keep all mount tabs readable on small screens
2026-10-27 Add recommended hybrid mount and grouped build navigation
2026-10-27 Remove owned aiming servos from purchase budgets
2026-10-27 Add optional wiring visualization to all mount builds
